limonit/opennixie/README.md

# Open Nixie Clock
Modular Clock based on Nixie Tubes

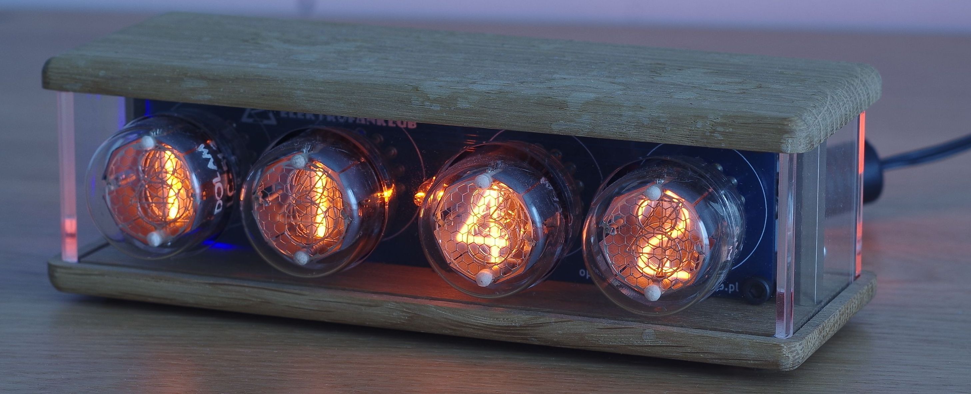
[picture p1: open-nixie.jpg]
Open Nixie
 

## What is it
Open Nixie is a modular design of a clock based on Nixie tubes.

## Homepage
More can be found at:
http://open-nixie.elektrofanklub.pl/
