limonit/opennixie/open-nixie_baseModule/open-nixie_baseModule2.jpg

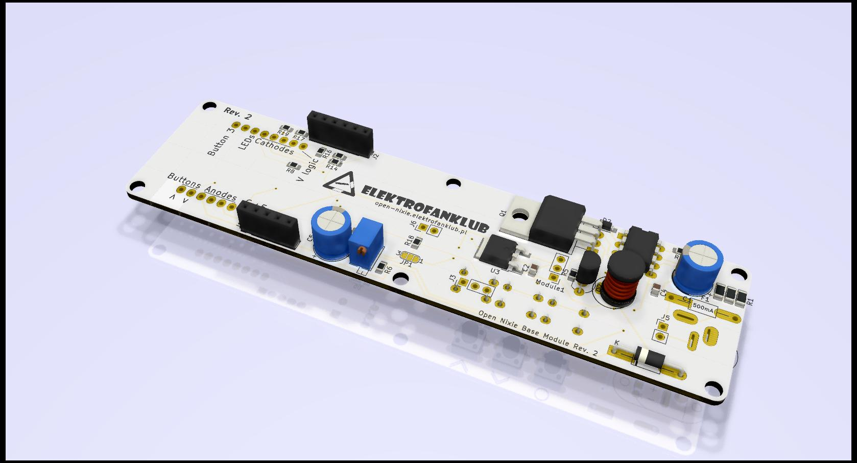
open-nixie_baseModule/open-nixie_baseModule2.jpg
