limonit/opennixie/open-nixie_baseModule/open-nixie_baseModule.kicad_pcb

## KiCad design open-nixie_baseModule/open-nixie_baseModule.kicad_pcb (2021-03-14)

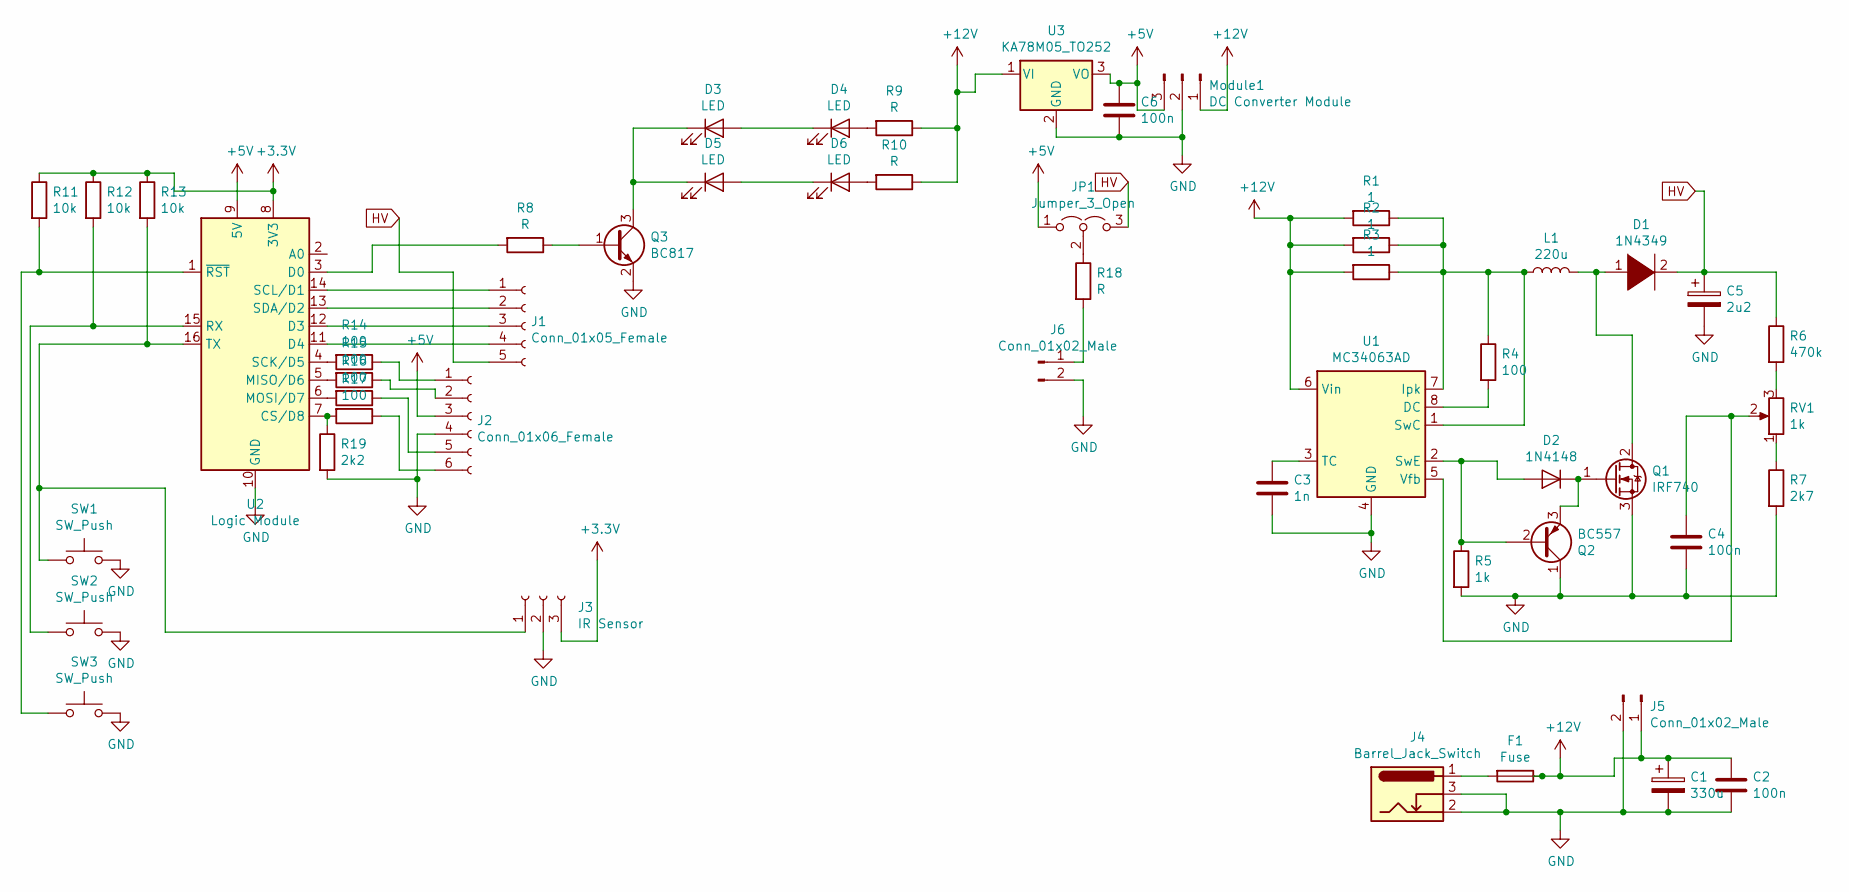
[picture p3: schematic open-nixie_baseModule.sch]

Parts:
C1: 330u; CP_Radial_D8.0mm_P3.80mm
C2, C4, C6: 100n; C_0805_2012Metric_Pad1.15x1.40mm_HandSolder
C3: 1n; C_0805_2012Metric_Pad1.15x1.40mm_HandSolder
C5: 2u2; CP_Radial_D8.0mm_P3.80mm
D1: 1N4349; D_DO-41_SOD81_P12.70mm_Horizontal
D2: 1N4148; D_SOD-123
D3, D4, D5, D6: LED; LED_PLCC_2835_Handsoldering
F1: Fuse; D_DO-41_SOD81_P12.70mm_Horizontal
J1: Conn_01x05_Female; PinHeader_1x05_P2.54mm_Vertical
J2: Conn_01x06_Female; PinHeader_1x06_P2.54mm_Vertical
J3: IR Sensor; PinHeader_1x03_P2.54mm_Vertical
J4: Barrel_Jack_Switch; DC_Jack_Vertical
J5, J6: Conn_01x02_Male; PinHeader_1x02_P2.54mm_Vertical
JP1: Jumper_3_Open; SolderJumper-3_P1.3mm_Open_RoundedPad1.0x1.5mm_NumberLabels
L1: 220u; Inductor_3_5
Module1: DC Converter Module; PinHeader_1x03_P2.54mm_Vertical
Q1: IRF740; TO-220-3_Horizontal_TabDown
Q2: BC557; TO-92_Inline_Wide
Q3: BC817; SOT-23_Handsoldering
R1, R2, R3: 1; R_1206_3216Metric_Pad1.42x1.75mm_HandSolder
R4, R14, R15, R16, R17: 100; R_0805_2012Metric_Pad1.15x1.40mm_HandSolder
R5: 1k; R_0805_2012Metric_Pad1.15x1.40mm_HandSolder
R6: 470k; R_0805_2012Metric_Pad1.15x1.40mm_HandSolder
R7: 2k7; R_0805_2012Metric_Pad1.15x1.40mm_HandSolder
R8, R9, R10, R18: R; R_0805_2012Metric_Pad1.15x1.40mm_HandSolder
R11, R12, R13: 10k; R_0805_2012Metric_Pad1.15x1.40mm_HandSolder
R19: 2k2; R_0805_2012Metric_Pad1.15x1.40mm_HandSolder
RV1: 1k; Potentiometer_Bourns_3266Z_Horizontal
SW1, SW2, SW3: SW_Push; SW_TH_Tactile_Omron_B3F-10xx_2pol
U1: MC34063AD; DIP-8_W7.62mm_LongPads
U2: Logic Module; wemos-d1-mini-with-pin-header-pin-correct
U3: KA78M05_TO252; TO-252-2

Connections:
+3V3: J3.3, R11.1, R12.1, R13.1, U2.8 (3V3)
+5V: C6.1, J2.3, JP1.1 (A), Module1.3, U2.9 (5V), U3.3 (VO)
+12V: C1.1, C2.1, F1.1, J5.1, Module1.1, R1.2, R2.2, R3.2, R9.1, R10.1, U1.6 (Vin), U3.1 (VI)
GND: C1.2, C2.2, C3.2, C4.2, C5.2, C6.2, J2.4, J3.2, J4.2, J4.3, J5.2, J6.2, Module1.2, Q1.3 (S), Q2.1 (C), Q3.2 (E), R5.2, R7.2, R19.2, SW1.2, SW2.2, SW3.2, U1.4 (GND), U2.10 (GND), U3.2 (GND)
HV: C5.1, D1.2 (A), J1.5, JP1.3 (B), R6.1
unnamed: C3.1, U1.3 (TC)
unnamed: C4.1, RV1.2, U1.5 (Vfb)
unnamed: D1.1 (K), L1.2, Q1.2 (D)
unnamed: D2.1 (K), Q1.1 (G), Q2.3 (E)
unnamed: D2.2 (A), Q2.2 (B), R5.1, U1.2 (SwE)
unnamed: D3.1 (K), D5.1 (K), Q3.3 (C)
unnamed: D3.2 (A), D4.1 (K)
unnamed: D4.2 (A), R9.2
unnamed: D5.2 (A), D6.1 (K)
unnamed: D6.2 (A), R10.2
unnamed: F1.2, J4.1
unnamed: J1.1, U2.14 (SCL/D1)
unnamed: J1.2, U2.13 (SDA/D2)
unnamed: J1.3, U2.12 (D3)
unnamed: J1.4, U2.11 (D4)
unnamed: J2.1, R14.1
unnamed: J2.2, R15.1
unnamed: J2.5, R16.1
unnamed: J2.6, R17.1
unnamed: J3.1, R13.2, SW1.1, U2.16 (TX)
unnamed: J6.1, R18.2
unnamed: JP1.2 (C), R18.1
unnamed: L1.1, R1.1, R2.1, R3.1, R4.1, U1.1 (SwC), U1.7 (Ipk)
unnamed: Q3.1 (B), R8.1
unnamed: R4.2, U1.8 (DC)
unnamed: R6.2, RV1.3
unnamed: R7.1, RV1.1
unnamed: R8.2, U2.3 (D0)
unnamed: R11.2, SW3.1, U2.1 (~RST)
unnamed: R12.2, SW2.1, U2.15 (RX)
unnamed: R14.2, U2.4 (SCK/D5)
unnamed: R15.2, U2.5 (MISO/D6)
unnamed: R16.2, U2.6 (MOSI/D7)
unnamed: R17.2, R19.1, U2.7 (CS/D8)

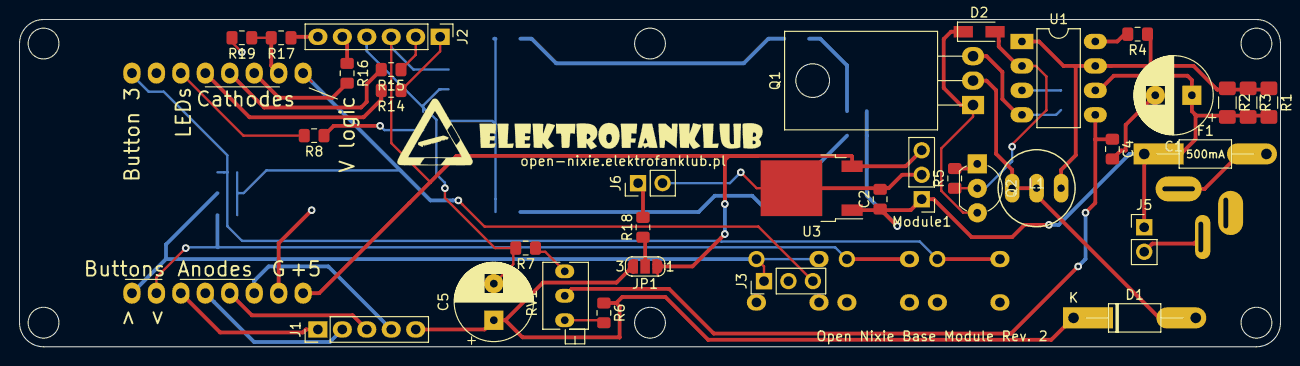
[picture p4: board open-nixie_baseModule.kicad_pcb from above]

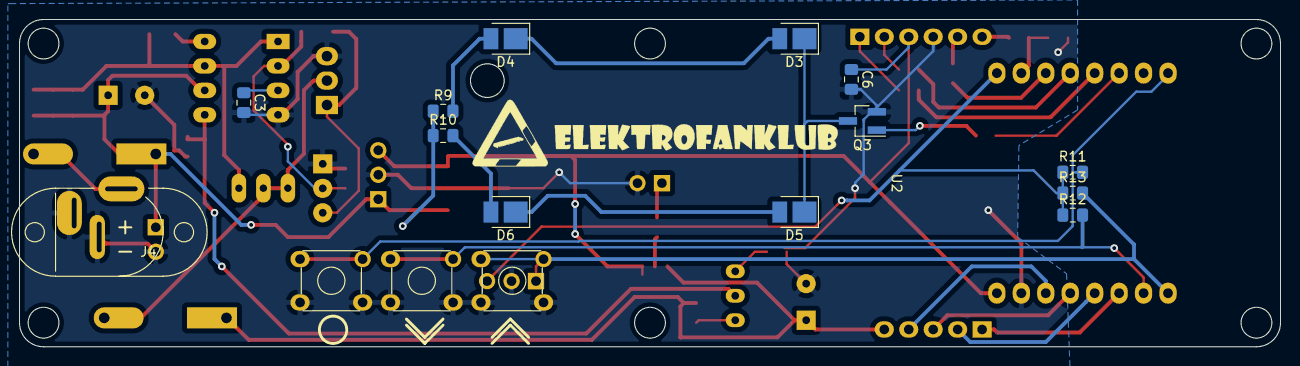
[picture p5: board open-nixie_baseModule.kicad_pcb from below]

Board: 2 copper layers, 131.0 x 34.0 mm, 51 parts (17 on the bottom side), 39 nets.
