limonit/opennixie/open-nixie_logicModuleM328/open-nixie_logicModuleM328.kicad_pcb

## KiCad design open-nixie_logicModuleM328/open-nixie_logicModuleM328.kicad_pcb (2021-03-14)

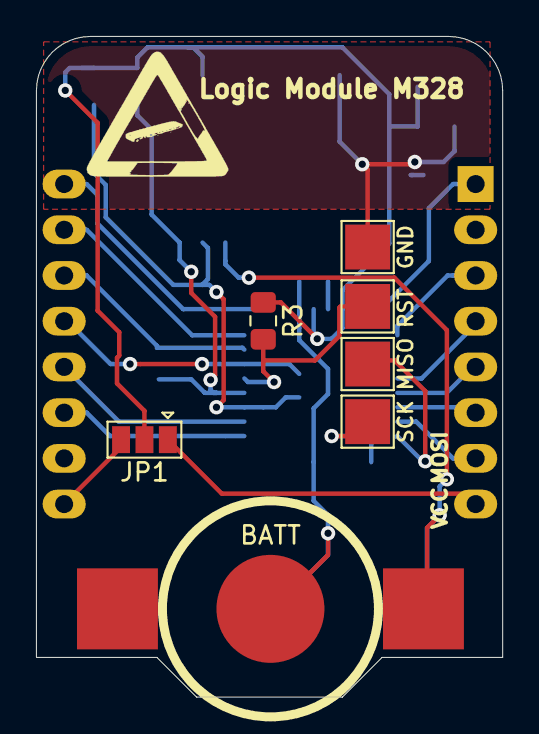
[picture p6: board open-nixie_logicModuleM328.kicad_pcb from above]

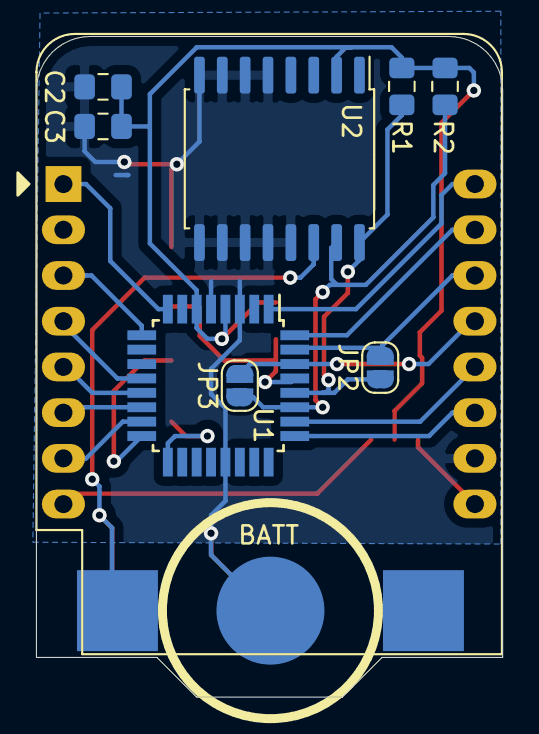
[picture p7: board open-nixie_logicModuleM328.kicad_pcb from below]

Board: 2 copper layers, 25.9 x 36.7 mm, 17 parts (10 on the bottom side), 22 nets.

Parts:
BATT: Battery_Cell; cr1225_battery
BATT#2: Battery_Cell; cr1225_battery
C1: WeMos_D1_mini; WEMOS_D1_mini_light
C2, C3: C; C_0805_2012Metric_Pad1.15x1.40mm_HandSolder
GND: TestPoint; TestPoint_Pad_2.5x2.5mm
JP1: Jumper_3_Open; SolderJumper-3_P1.3mm_Open_Pad1.0x1.5mm
JP2, JP3: Jumper_NO_Small; SolderJumper-2_P1.3mm_Open_RoundedPad1.0x1.5mm
MISO: TestPoint; TestPoint_Pad_2.5x2.5mm
R1, R2, R3: R; R_0805_2012Metric_Pad1.15x1.40mm_HandSolder
RST: TestPoint; TestPoint_Pad_2.5x2.5mm
SCK: TestPoint; TestPoint_Pad_2.5x2.5mm
U1: ATmega328P-AU; TQFP-32_7x7mm_P0.8mm
U2: DS3231M; SOIC-16W_7.5x10.3mm_P1.27mm

Connections:
GND: BATT.2, BATT#2.2, C1.10, C2.1, C3.1, GND.1, U1.3, U1.5, U1.21, U2.5, U2.6, U2.7, U2.8, U2.9, U2.10, U2.11, U2.12, U2.13
unnamed: BATT.1, BATT#2.1, U2.14
unnamed: C1.1, U1.8
unnamed: C1.3, U1.9
unnamed: C1.4, U1.12
unnamed: C1.5, U1.13
unnamed: C1.6, U1.14
unnamed: C1.7, U1.15
unnamed: C1.8, JP1.1
unnamed: C1.9, JP1.3
unnamed: C1.11, U1.25
unnamed: C1.12, U1.26
unnamed: C1.13, JP3.2, U1.30
unnamed: C1.14, JP2.2, U1.31
unnamed: C1.15, U1.32
unnamed: C1.16, U1.1
unnamed: JP2.1, R1.2, U1.28, U2.16
unnamed: JP3.1, R2.2, U1.27, U2.15
unnamed: R3.2, RST.1, U1.29
unnamed: MISO.1, U1.16
unnamed: SCK.1, U1.17
VCC: C2.2, C3.2, JP1.2, R1.1, R2.1, R3.1, U1.4, U1.6, U2.2
