limonit/opennixie/open-nixie_displayModule/open-nixie_displayModule.kicad_pcb

## KiCad design open-nixie_displayModule/open-nixie_displayModule.kicad_pcb (2021-03-14)

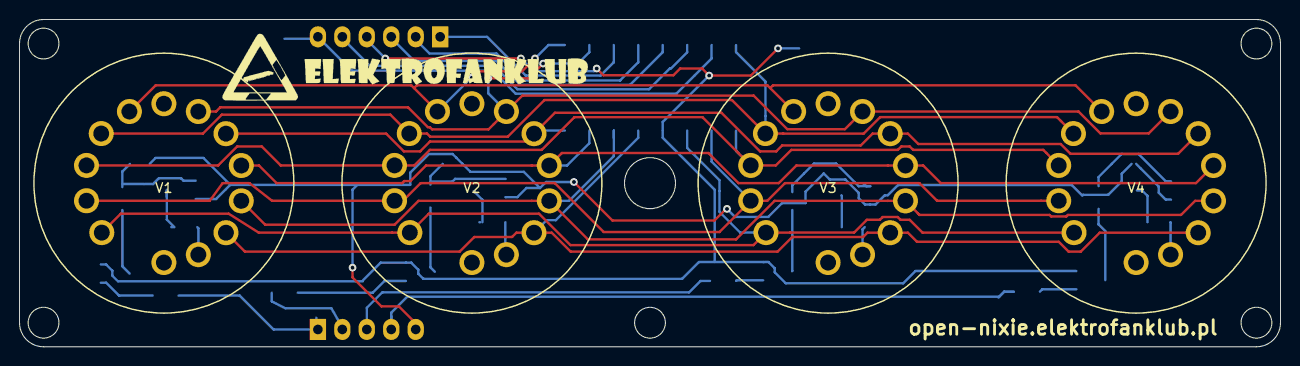
[picture p8: board open-nixie_displayModule.kicad_pcb from above]

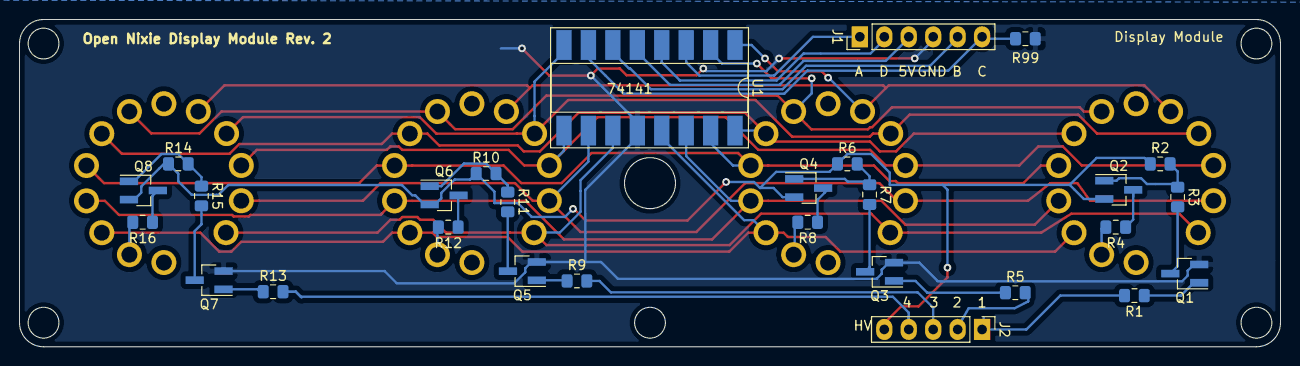
[picture p9: board open-nixie_displayModule.kicad_pcb from below]

Board: 2 copper layers, 131.0 x 34.0 mm, 32 parts (28 on the bottom side), 41 nets.

Parts:
J1: Conn_01x06_Male; PinHeader_1x06_P2.54mm_Vertical
J2: Conn_01x05_Male; PinHeader_1x05_P2.54mm_Vertical
Q1, Q3, Q5, Q7: MMBTA42; SOT-23_Handsoldering
Q2, Q4, Q6, Q8: MMBTA92; SOT-23_Handsoldering
R1, R5, R9, R13: 33k; R_0805_2012Metric_Pad1.15x1.40mm_HandSolder
R2, R6, R10, R14: 100k; R_0805_2012Metric_Pad1.15x1.40mm_HandSolder
R3, R7, R11, R15: 470k; R_0805_2012Metric_Pad1.15x1.40mm_HandSolder
R4, R8, R12, R16: 10k; R_0805_2012Metric_Pad1.15x1.40mm_HandSolder
R99: 2k2; R_0805_2012Metric_Pad1.15x1.40mm_HandSolder
U1: 74141; DIP-16_W8.89mm_SMDSocket_LongPads
V1, V2, V3, V4: LC513; LC-513

Connections:
/A1: R4.2, V1.A
/A2: R8.2, V2.A
/A3: R12.2, V3.A
/A4: R16.2, V4.A
/C1: U1.11, V1.1, V2.1, V3.1, V4.1
/C2: U1.10, V1.2, V2.2, V3.2, V4.2
/C3: U1.9, V1.3, V2.3, V3.3, V4.3
/C4: U1.8, V1.4, V2.4, V3.4, V4.4
/C5: U1.1, V1.5, V2.5, V3.5, V4.5
/C6: U1.2, V1.6, V2.6, V3.6, V4.6
/C7: U1.16, V1.7, V2.7, V3.7, V4.7
/C8: U1.15, V1.8, V2.8, V3.8, V4.8
/C9: U1.14, V1.9, V2.9, V3.9, V4.9
/C10: U1.13, V1.0, V2.0, V3.0, V4.0
GND: J1.4, Q1.2, Q3.2, Q5.2, Q7.2, R99.2, U1.12
unnamed: J1.1, U1.3
unnamed: J1.2, U1.4
unnamed: J1.5, U1.6
unnamed: J1.6, R99.1, U1.7
unnamed: J2.1, R1.2
unnamed: J2.2, R5.2
unnamed: J2.3, R9.2
unnamed: J2.4, R13.2
unnamed: J2.5, Q2.2, Q4.2, Q6.2, Q8.2, R2.1, R6.1, R10.1, R14.1
unnamed: Q1.1, R1.1
unnamed: Q1.3, R3.2
unnamed: Q2.1, R2.2, R3.1
unnamed: Q2.3, R4.1
unnamed: Q3.1, R5.1
unnamed: Q3.3, R7.2
unnamed: Q4.1, R6.2, R7.1
unnamed: Q4.3, R8.1
unnamed: Q5.1, R9.1
unnamed: Q5.3, R11.2
unnamed: Q6.1, R10.2, R11.1
unnamed: Q6.3, R12.1
unnamed: Q7.1, R13.1
unnamed: Q7.3, R15.2
unnamed: Q8.1, R14.2, R15.1
unnamed: Q8.3, R16.1
VCC: J1.3, U1.5
