limonit/opennixie/Avr/openNixiem328/openNixiem328/main.h

/*
 * main.h
 *
 * Created: 2020-09-13 19:21:45
 *  Author: Trojan
 */ 


#ifndef MAIN_H_
#define MAIN_H_

enum Mode {DISPLAY_TIME, SET_TIME, SET_TIME_HACK, SET_DIM, SET_LED, SET_CROSSFADE};

#endif /* MAIN_H_ */
