limonit/opennixie/PiPicoPio/ntp_client.c

#include "ntp_client.h"
//#include "main.h"
#include "hardware/rtc.h"

extern int8_t timezone;
// Called with results of operation
void ntp_result(NTP_T* state, int status, time_t *result) {
    if (status == 0 && result) {
        struct tm *utc = gmtime(result);
        printf("got ntp response: %02d/%02d/%04d %02d:%02d:%02d\n", utc->tm_mday, utc->tm_mon + 1, utc->tm_year + 1900,
               utc->tm_hour, utc->tm_min, utc->tm_sec);
      datetime_t t = {
         .year  = 2020,
         .month = 06,
         .day   = 05,
         .dotw  = 5, // 0 is Sunday, so 5 is Friday
         .hour  = utc->tm_hour,
         .min   = utc->tm_min,
         .sec   = utc->tm_sec
    };
    rtc_set_datetime(&t);
    }

    if (state->ntp_resend_alarm > 0) {
        cancel_alarm(state->ntp_resend_alarm);
        state->ntp_resend_alarm = 0;
    }
    state->ntp_test_time = make_timeout_time_ms(NTP_TEST_TIME);
    state->dns_request_sent = false;
}

// Make an NTP request
void ntp_request(NTP_T *state) {
    // cyw43_arch_lwip_begin/end should be used around calls into lwIP to ensure correct locking.
    // You can omit them if you are in a callback from lwIP. Note that when using pico_cyw_arch_poll
    // these calls are a no-op and can be omitted, but it is a good practice to use them in
    // case you switch the cyw43_arch type later.
    cyw43_arch_lwip_begin();
    struct pbuf *p = pbuf_alloc(PBUF_TRANSPORT, NTP_MSG_LEN, PBUF_RAM);
    uint8_t *req = (uint8_t *) p->payload;
    memset(req, 0, NTP_MSG_LEN);
    req[0] = 0x1b;
    udp_sendto(state->ntp_pcb, p, &state->ntp_server_address, NTP_PORT);
    pbuf_free(p);
    cyw43_arch_lwip_end();
}

int64_t ntp_failed_handler(alarm_id_t id, void *user_data)
{
    NTP_T* state = (NTP_T*)user_data;
    printf("ntp request failed\n");
    ntp_result(state, -1, NULL);
    return 0;
}

// Call back with a DNS result
void ntp_dns_found(const char *hostname, const ip_addr_t *ipaddr, void *arg) {
    NTP_T *state = (NTP_T*)arg;
    if (ipaddr) {
        state->ntp_server_address = *ipaddr;
        printf("ntp address %s\n", ipaddr_ntoa(ipaddr));
        ntp_request(state);
    } else {
        printf("ntp dns request failed\n");
        ntp_result(state, -1, NULL);
    }
}

// NTP data received
void ntp_recv(void *arg, struct udp_pcb *pcb, struct pbuf *p, const ip_addr_t *addr, u16_t port) {
    NTP_T *state = (NTP_T*)arg;
    uint8_t mode = pbuf_get_at(p, 0) & 0x7;
    uint8_t stratum = pbuf_get_at(p, 1);

    // Check the result
    if (ip_addr_cmp(addr, &state->ntp_server_address) && port == NTP_PORT && p->tot_len == NTP_MSG_LEN &&
        mode == 0x4 && stratum != 0) {
        uint8_t seconds_buf[4] = {0};
        pbuf_copy_partial(p, seconds_buf, sizeof(seconds_buf), 40);
        uint32_t seconds_since_1900 = seconds_buf[0] << 24 | seconds_buf[1] << 16 | seconds_buf[2] << 8 | seconds_buf[3];
        uint32_t seconds_since_1970 = seconds_since_1900 - NTP_DELTA;
        time_t epoch = seconds_since_1970;
        ntp_result(state, 0, &epoch);
    } else {
        printf("invalid ntp response\n");
        ntp_result(state, -1, NULL);
    }
    pbuf_free(p);
}

// Perform initialisation
NTP_T* ntp_init(void) {
    NTP_T *state = (NTP_T*)calloc(1, sizeof(NTP_T));
    if (!state) {
        printf("failed to allocate state\n");
        return NULL;
    }
    state->ntp_pcb = udp_new_ip_type(IPADDR_TYPE_ANY);
    if (!state->ntp_pcb) {
        printf("failed to create pcb\n");
        free(state);
        return NULL;
    }
    udp_recv(state->ntp_pcb, ntp_recv, state);
    return state;
}
