limonit/opennixie/PiPicoPio/displayHAL.h

/*
 * displayHAL.h
 *
 * Created: 2020-06-15 23:51:23
 *  Author: Trojan
 */ 

#include <stdbool.h>
#include "pico/stdlib.h"

#ifndef DISPLAYHAL_H_
#define DISPLAYHAL_H_

void displayHALputData(uint8_t a, uint8_t b, uint8_t c, uint8_t d);


#endif /* DISPLAYHAL_H_ */
